algordeev/autonomous-tram-system/images/remote2.JPG

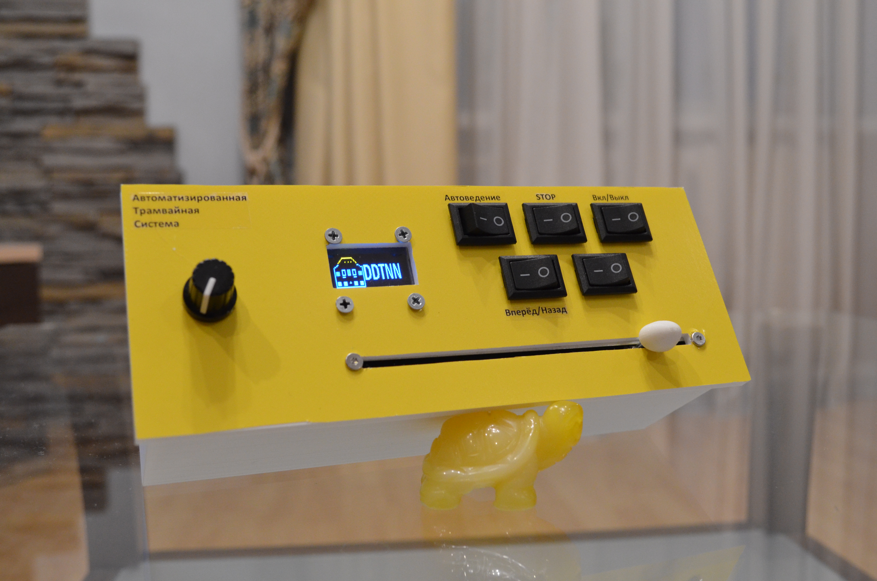
images/remote2.JPG
