algordeev/autonomous-tram-system/images/remote.JPG

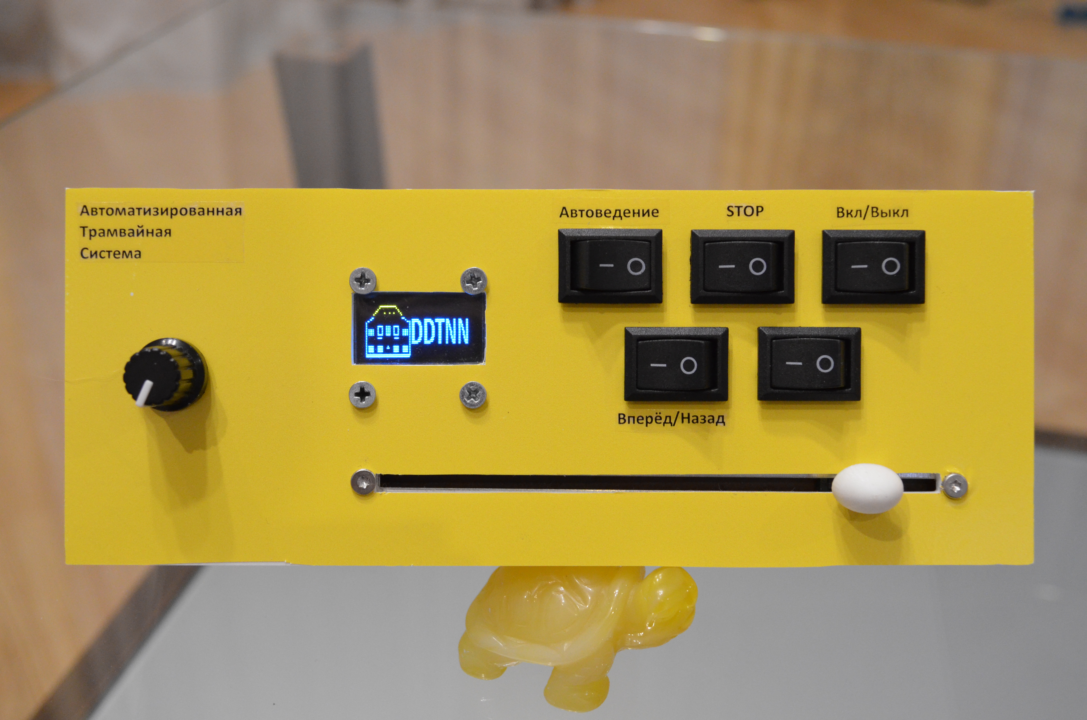
images/remote.JPG
