algordeev/autonomous-tram-system/images/tram.JPG

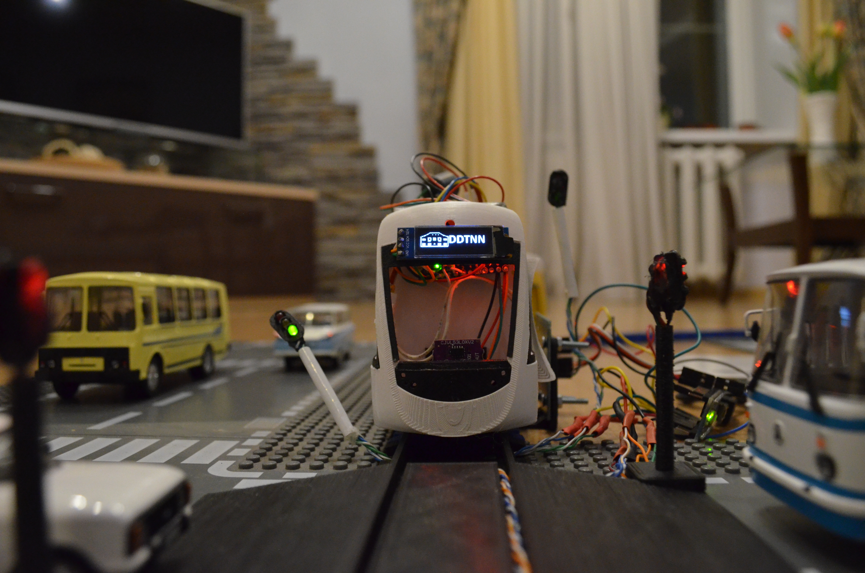
images/tram.JPG
