algordeev/autonomous-tram-system/schemes/Schematic_tram_controller.pdf

## GND

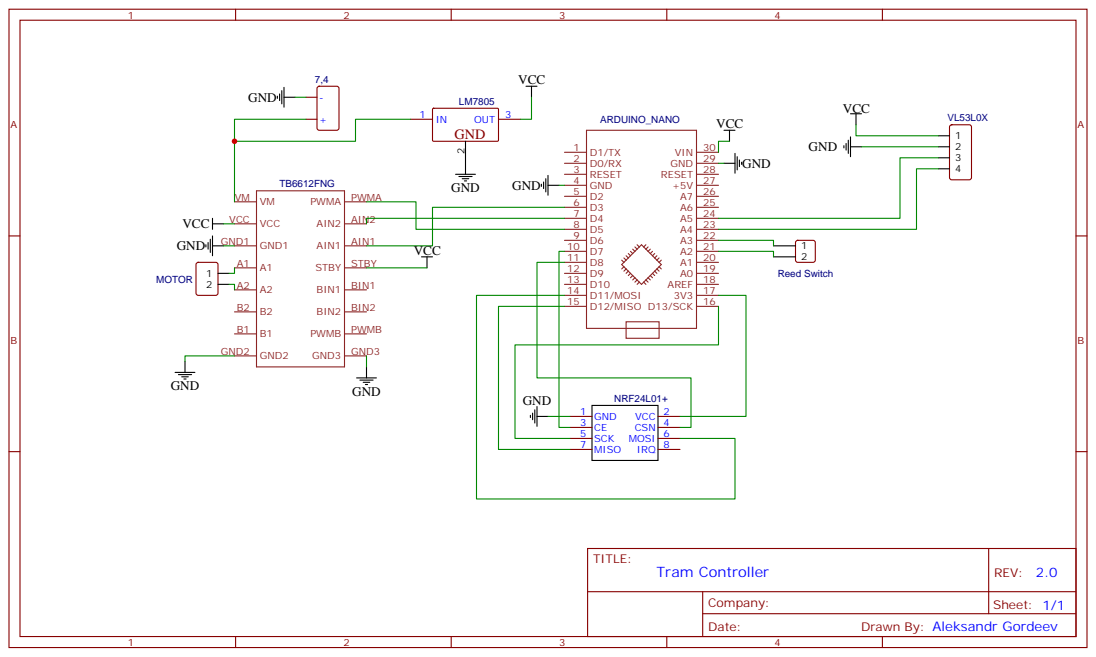
[picture p7: page 1]

Drawn By: Aleksandr Gordeev
