algordeev/autonomous-tram-system/schemes/Schematic_traffic_lights_controller.pdf

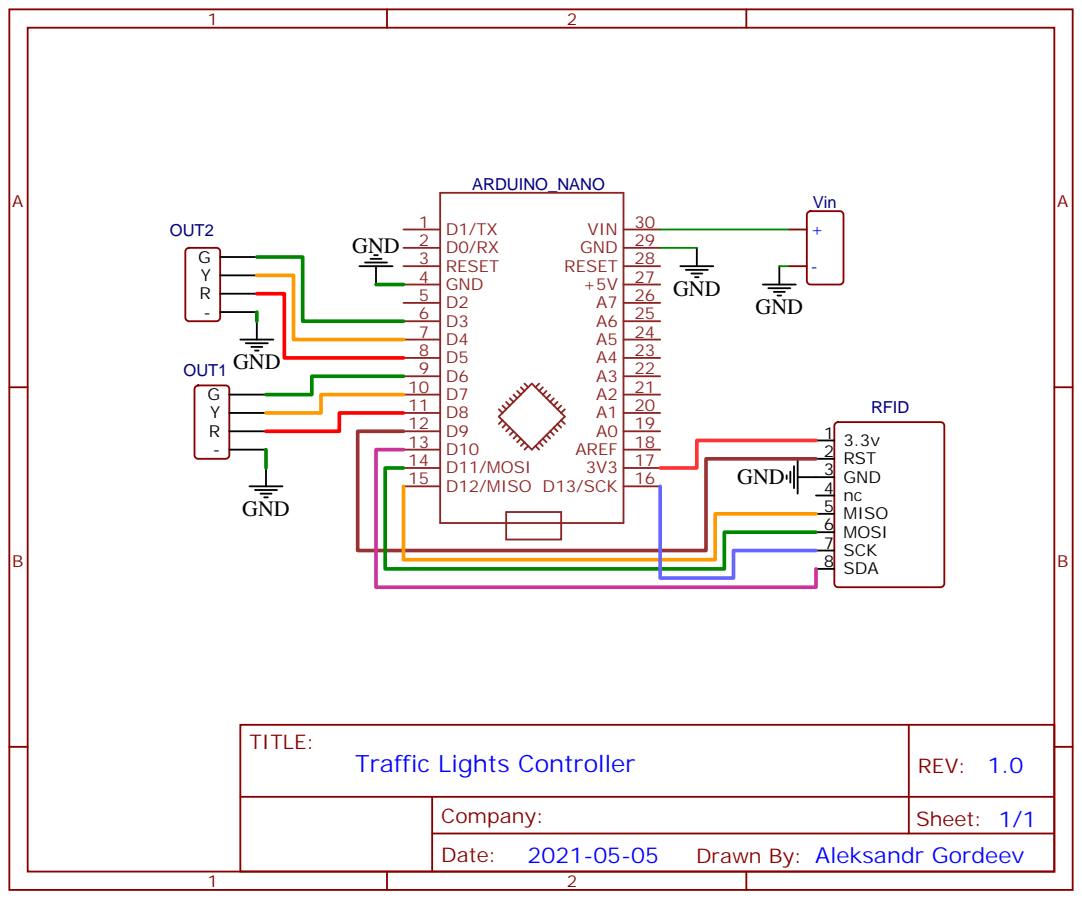
[picture p8: page 1]

Drawn By: Aleksandr Gordeev
