algordeev/autonomous-tram-system/schemes/PCB_remote_controller.pdf

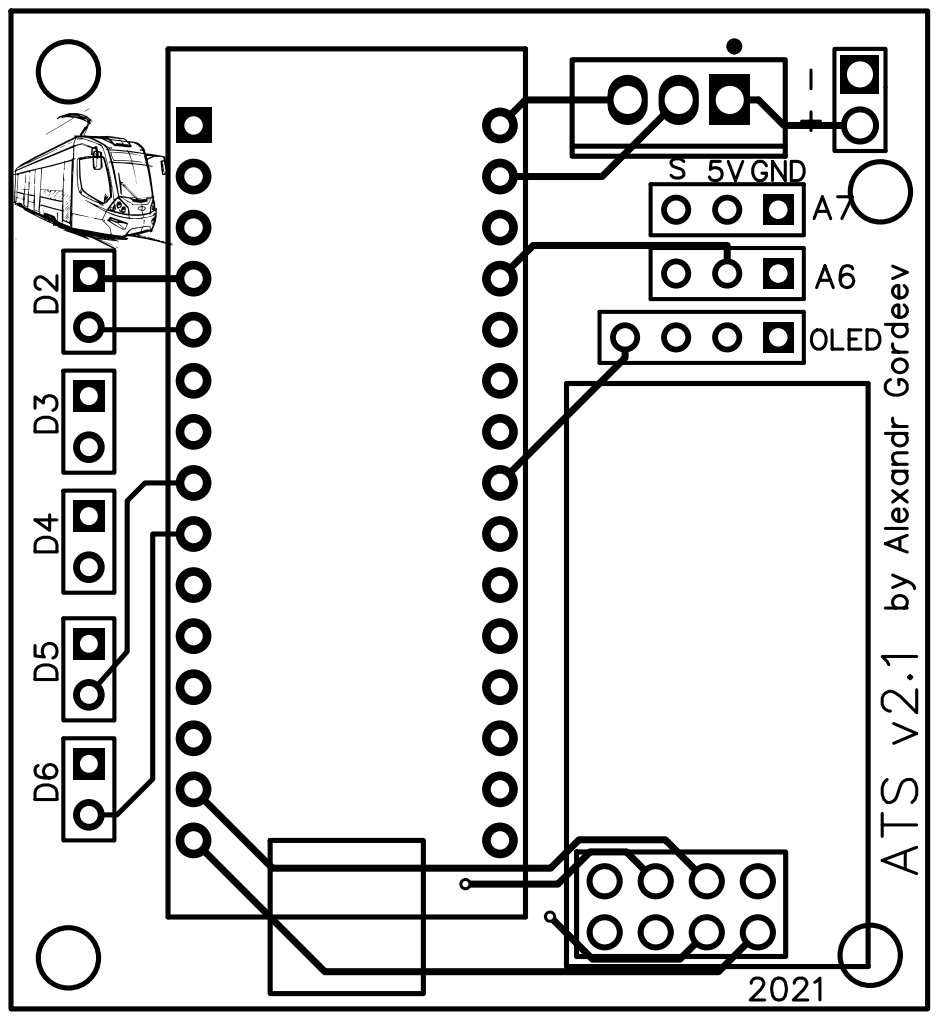
[picture p9: page 1]
