algordeev/autonomous-tram-system/schemes/PCB_tram_controller.pdf

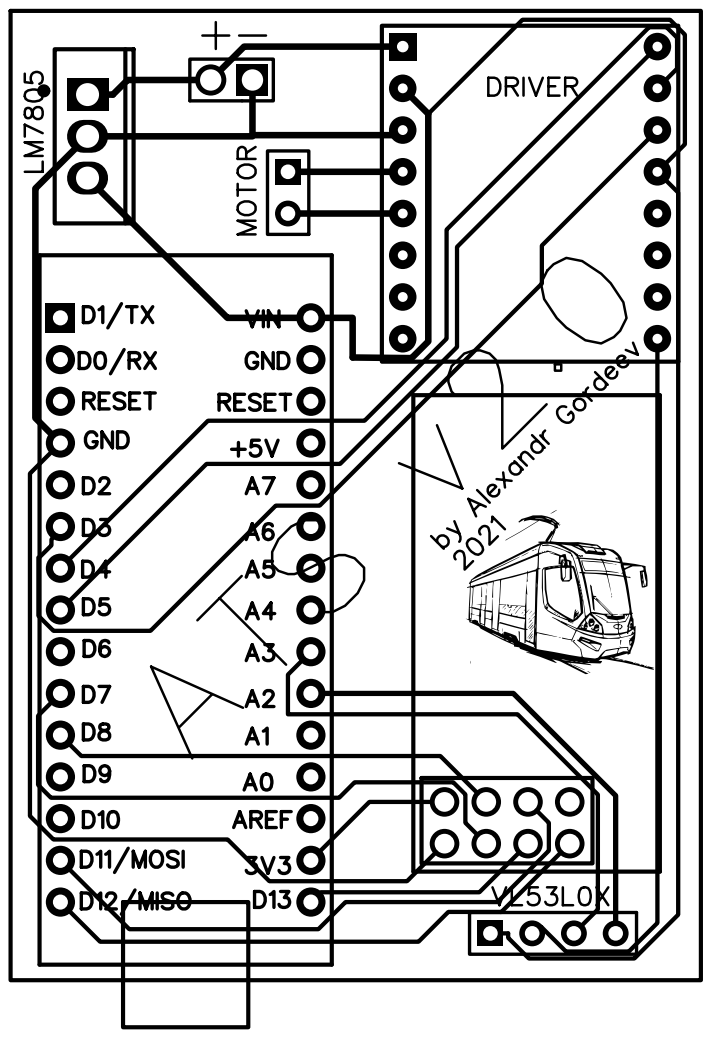
[picture p10: page 1]
